chairaudio/ILSE/README.md

# ILSE. An Analog Monophonic Synthesizer Module

Schematic

Ilse is designed as a low cost, easy to build, but still flexible and feature rich synthesizer. 
It is based on Syntherjacks single-chip synthesizer [Totoro](https://syntherjack.net/totoro-1-ic-simple-synth/) and extends the design for voltage control on filter, oscillators and LFO.

## History
If you want to see the revision 1 of ILSE (as a reference if you have a REV 1 layout) make sure to check out the rev1 tag with `git checkout tags/rev1`

If you want to see the revision 2 of ILSE (as a reference if you have a REV 2 layout) make sure to check out the rev2 tag with `git checkout tags/rev2`

## Features
10 HP Eurorack module

Components: 

- two saw tooth oscillators
- brigded-T low pass filter with resonance switch 
- triangle LFO with speed control, and routing to filter or oscillators
- simple mixer and detune for oscillators
- level control
- external filter input

Modulation Inputs: 

- 1V/Oct input for oscillators
- Gate
- Filter Cutoff (exponential)
- LFO Speed (linear, via pin header)
- Oscillator 2 detune (linear, via pin header)

You might as well just examine the schematics in the simulator and  build your own synthesizer from it. It uses a neat trick to build the  exponential converters directly into the saw tooth oscillators as you  can see from the simulation below. Note that the tuning of the  oscillators is not temperature compensated and will thus change with  room temperature. We would not recommend using Ilse in a stage situation where reliable and exact pitches are important.

[Saw Tooth Oscillators](http://www.falstad.com/circuit/circuitjs.html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)

It features a simple voltage controllable low pass filter that you can modulate with the inbuilt LFO or an external source.

[Voltage Controlled Filter](http://www.falstad.com/circuit/circuitjs.html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)

Ilse was designed for educational use and was used in an introduction to electronics course. For more details on the schematics see the [course material](https://www.uni-weimar.de/kunst-und-gestaltung/wiki/IFD:Analog_Circuits_and_Interfaces_WS20_21/introduction_to_electronics).

## Kit building

Here you can find the [schematic](ilse.pdf) and [build instructions](https://discourse.chair.audio/t/ilse-build-instructions-for-revision-4/151/3). The [iBOM](https://chairaudio.github.io/ILSE/REV4.html) will help you assemble the kit.

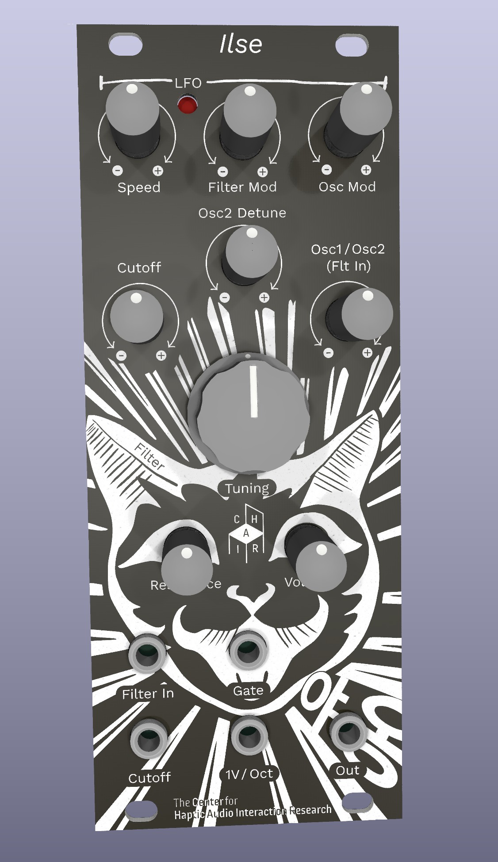
[picture p1: 3d_viewer.jpg]
KiCad 3d view


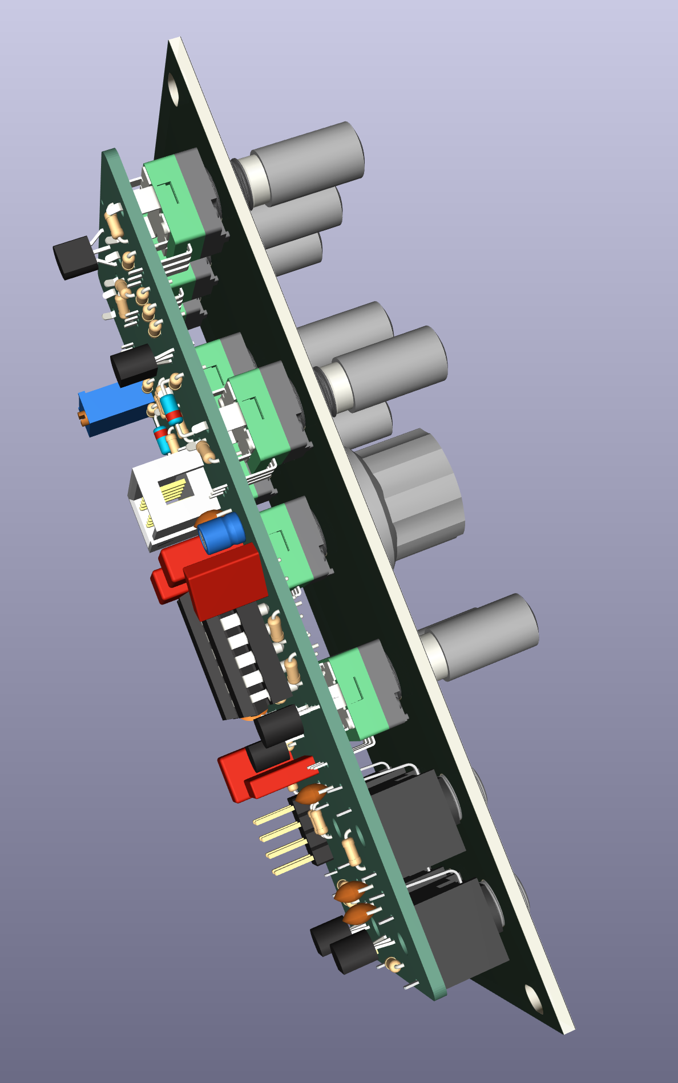
[picture p2: ilse2.png]


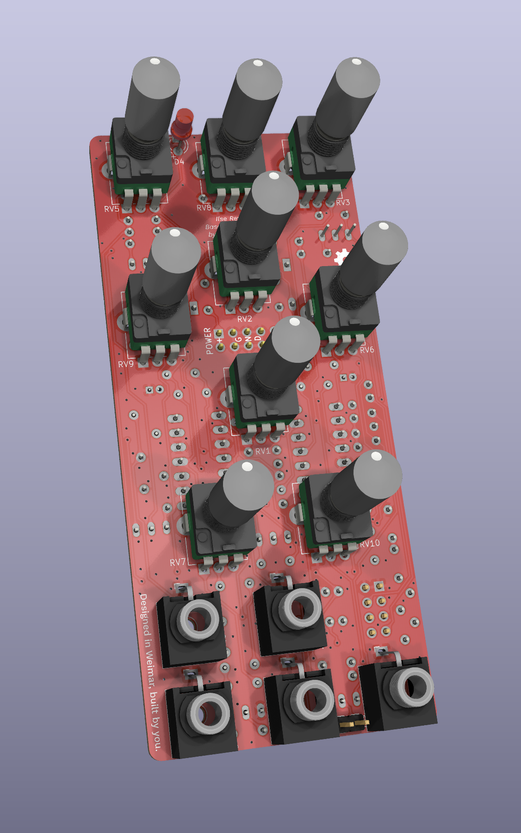
[picture p3: ilse3.png]


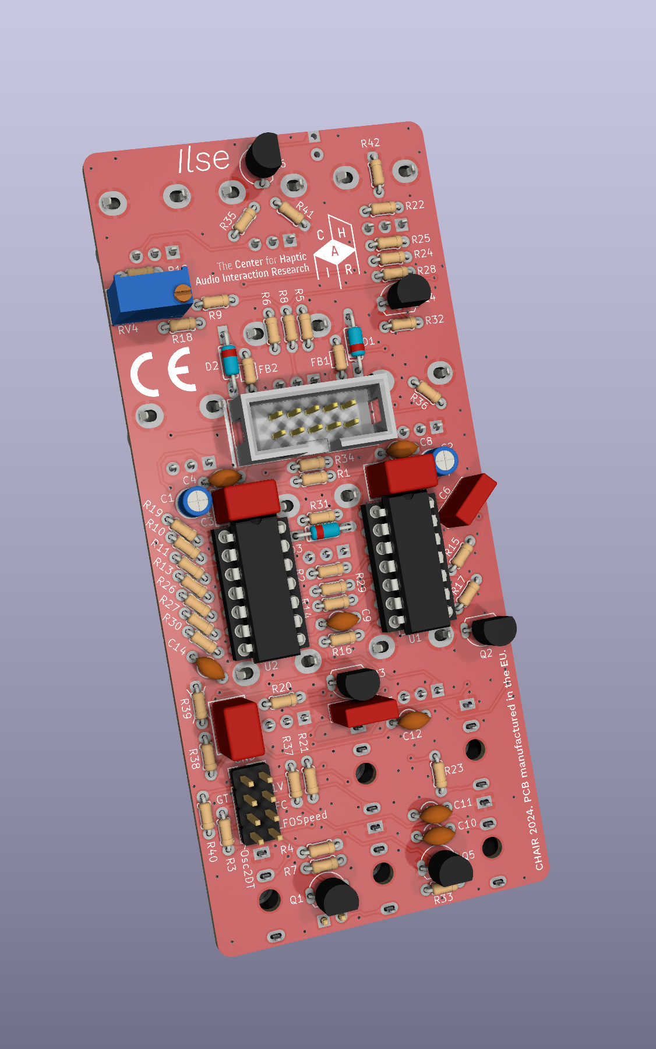
[picture p4: ilse4.png]
