chairaudio/ILSE/ilse_with_type.ods

ILSE Analog Synthesizer Module Parts List
Item No. | Type | Qty | Value
1 | Ceramic or Electrolytic Capacitor | 3 | 1u
2 | Ceramic Capacitor | 2 | 0.1u
3 | Ceramic Capacitor | 2 | 10n
4 | Ceramic Capacitor | 1 | 47n
5 | Ceramic Capacitor | 2 | 22n
6 | Ceramic Capacitor | 1 | 1n
7 | Electrolytic Capacitor | 2 | 10u
8 | Quad Operational Amplifier Chip | 2 | TL074 (evtl. Replace?)
9 | Leds | 2
10 | Mono Audio Connector Jack 3.5mm | 1
11 | Pin Header 2x5, 2.54mm Pin Distance | 1
12 | Pin Header 2x3, 2.54mm Pin Distance | 1
13 | Mono Audio Connector Jack 3.5mm | 1
14 | Mono Audio Connector Jack 3.5mm | 1
15 | Mono Audio Connector Jack 3.5mm | 1
16 | Mono Audio Connector Jack 3.5mm | 1
17 | Pin Header 2x1, 2.54mm Pin Distance | 1
18 | PNP Transistor | 3 | BC560 / BC558
19 | NPN Transistor | 3 | BC550 / BC548
20 | Resistor through-hole | 3 | 4k7
21 | Resistor through-hole | 7 | 47k
22 | Resistor through-hole | 10 | 100k
23 | Resistor through-hole | 3 | 1k
24 | Resistor through-hole | 1 | 22k
25 | Resistor through-hole | 2 | 1k
26 | Resistor through-hole | 3 | 47k
27 | Resistor through-hole | 4 | 100k
28 | Resistor through-hole | 1 | 1.5k
29 | Resistor through-hole | 4 | 10k
30 | Resistor through-hole | 1 | 2k2
31 | Potentiometer linear | 1 | 5kB
32 | Potentiometer linear | 5 | 100kB
33 | Trimmer, Trim-potentiometer | 1 | 500
34 | Potentiometer linear | 1 | 100kA
35 | Switch, DTDP | 1 | Power Switch
36 | Switch, DTDP | 1 | LFO Switch
37 | Switch, DTDP | 1 | Resonance Switch
