chairaudio/ILSE/ilse.pdf

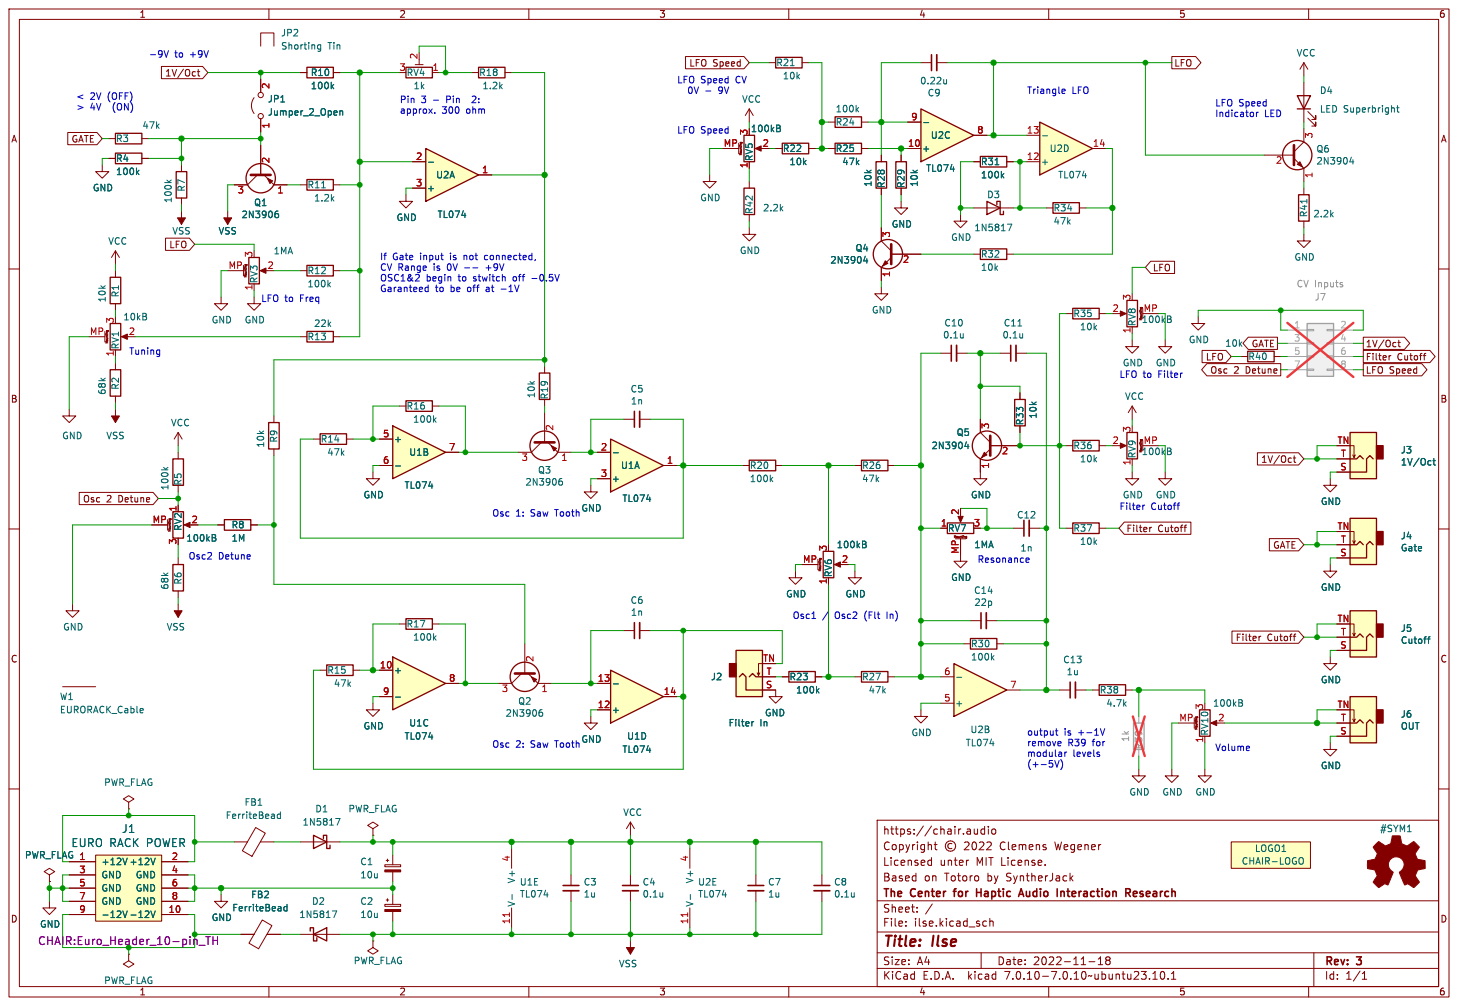
[picture p5: page 1]

LFO Speed
LFO to Filter LFO Speed CV

LFO to Freq < 2V (OFF) > 4V (ON)
