chairaudio/ILSE/(threads)

Thread 11 (2022-12-09):

pots: OSC2 opposite direction

mxa, 2022-12-09:

mxa, 2022-12-11:
So just flip pins 1 and 3 of OSC2 detune?

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

clwe, 2022-12-11:
Yes, a more negative voltage on the transistor increases the conductance and thus will tune the oscillator higher. I didn't think about this in the previous revisions.

Closed 2022-12-11.

Thread 13 (2022-12-09):

check filter input impedance

clwe, 2022-12-09:
Maybe input impedance for the filter could be improved by choosing R33 & R30 to be 100k instead of 10k.
Needs testing because filter linearising resistor may be impacted.

clwe, 2023-05-27:
fixed in commit 68551501455ced69077ff11da6b6c52eb0b032d7
The issue may not have been input impedance but rather the mixing of CV in front of the filter transistor. The CV range should be improved now.

Closed 2023-05-27.

Thread 4 (2022-12-09):

Diodes missing on BOM

mxa, 2022-12-09:

Closed 2023-05-27.

Thread 19 (2023-10-05):

change diode types

mxa, 2023-10-05:

mxa, 2023-10-05:
fixed with 2be08bc7447451915e4d4985e003920598b6d914

Closed 2023-10-05.

Thread 21 (2024-01-05):

osc modulation audible when fully turned down

clwe, 2024-01-05:
osc modulation audible when fully turned down. probably an impedance issue

clwe, 2024-01-05:
maybe fixed by 6c2b35c70b13fd999f63e0441a15eb7f75b7e570  (using larger tuning resistors)

clwe, 2024-01-06:
tested, mainly fixed with https://github.com/chairaudio/ILSE/commit/6c2b35c70b13fd999f63e0441a15eb7f75b7e570.
It wasn't the osc modulation, but cross modulation of oscillators that caused oscillators to be unstable. Cross modulation is decreased with bigger resistors.

Closed 2024-01-06.

Thread 25 (2025-01-28):

silkscreen label flt in should align right on osc1/osc2 mix

clwe, 2025-01-28:
external filter in replaces osc2 when something is plugged in.
to hear only the filter input the mix knob should be fully turned right

mxa, 2025-01-28:
Is this an issue for the frontplate design or the PCB?

clwe, 2025-01-28:
frontplate. just the silkscreen should be differntly aligned to give an indication where to turn the knob for external filter input
