chairaudio/ILSE/(commit log)

2021-01-17 add schematic and 3D Viewer screenshot
2021-01-17 adds schematic as png file
2021-12-09 choose volume pot as linear type
    [ilse.kicad_sch, ilse_rev1.ods]
2021-12-09 update README.md: include links to build instructions, simulations and course material
2022-11-18 incorporates max's powersupply protection
    [ilse.kicad_pcb, ilse.kicad_sch]
2022-11-18 removes filter distortion, cutoff modulation range is 0V - +10V, instead of -10V - +10V
    [ilse.kicad_sch]
2022-11-20 added hybrid lib
    [ilse.kicad_pcb, ilse.kicad_sch]
2022-11-22 include manf# for rev2
    [ilse.kicad_sch]
2022-11-23 edits in schematic
    [ilse.kicad_pcb, ilse.kicad_sch]
2022-11-23 adds old rev1 pcb
    [ilse-rev1.kicad_pcb]
2022-11-24 layout remake in process
    [ilse-rev1.kicad_pcb, ilse-rev2.kicad_pcb, ilse.kicad_pcb, ilse.kicad_sch]
2022-11-26 finished routing and squashed DRC errors down to 0
    [ilse.kicad_pcb, ilse.kicad_sch]
2022-11-27 started frontpanel file
    [frontpanel.kicad_pcb, frontpanel.kicad_sch, ilse-rev2.kicad_pcb, ilse.kicad_pcb]
2022-11-28 holes completed on frontpanel
    [frontpanel.kicad_pcb, ilse.kicad_pcb]
2022-11-29 frontpanel functional, CV input GND added
    [frontpanel.kicad_pcb, frontpanel.kicad_sch, ilse.kicad_pcb, ilse.kicad_sch]
2022-11-30 ready for review
    [frontpanel.kicad_pcb, ilse.kicad_pcb]
2022-11-30 JLCJLCJLCJLC added to PCBs
    [frontpanel.kicad_pcb, ilse.kicad_pcb]
2022-11-30 added visual gimmmicks
    [frontpanel.kicad_pcb, ilse.kicad_pcb]
2022-11-30 replaces resonance switch with pot
    [ilse.kicad_sch]
2022-11-30 connected pin 3 of RV9
    [ilse.kicad_pcb, ilse.kicad_sch]
2022-11-30 added fabrication output
    [frontpanel.kicad_pcb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]
2022-12-09 turned R13 label upright, closes #5, make LED footprint polarizaton evident, closes #2
    [ilse.kicad_pcb, ilse.kicad_sch]
2022-12-09 swap Freq Cutoff labels on Frontpanel, closes #10
    [frontpanel.kicad_pcb]
2022-12-09 make EURORACK Power footprint more evident, closes #3
    [ilse.kicad_pcb]
2022-12-09 close unconnected pins: Diode-Reistor Ratsnest, closes #9
    [ilse.kicad_pcb]
2022-12-10 updated images and schematic pdf for readme, closes #6
2022-12-11 inverse rotation on RV2, fixes #11
    [ilse.kicad_pcb, ilse.kicad_sch]
2023-01-28 changed RV9 from 1MB to 1MA, fixes #14
    [ilse.kicad_sch]
2023-01-30 added EURORACK Ribbon cable to schematic, layout and BOM, must update CHAIR library. fixes #15
    [ilse.kicad_pcb, ilse.kicad_sch]
2023-05-27 remove switch, add knob: LFO to filter depth, bigger filter caps
    [ilse.kicad_sch]
2023-05-27 replaces LFO cap to match cap in filter
    [ilse.kicad_sch]
2023-05-27 changes diodes from 1N5819 to 1N5818 (smaller Vf), fixes #4
    [ilse.kicad_sch]
2023-10-03 placing done
    [ilse.kicad_pcb, ilse.kicad_sch, ilseREV2.kicad_pcb]
2023-10-03 routing done
    [ilse.kicad_pcb]
2023-10-04 labels positioned
    [ilse.kicad_pcb]
2023-10-05 minor optimizations
    [ilse.kicad_pcb, ilse.kicad_sch]
2023-10-05 chaged diodes and transistors to alternatives
    [ilse.kicad_pcb, ilse.kicad_sch]
2023-10-05 routing optimizations
    [ilse.kicad_pcb, ilse.kicad_sch]
2023-10-05 exchanged pot and trimmer values, fixes #18
    [ilse.kicad_pcb, ilse.kicad_sch]
2023-10-05 added teardrops
    [ilse.kicad_pcb]
2023-10-15 finished routing
    [frontpanel.kicad_pcb, ilse.kicad_sch]
2023-10-15 updated layout and schematic
    [ilse.kicad_sch]
2023-10-15 removed resistor for standalone mode
    [ilse.kicad_sch]
2023-10-15 updated frontpanel
    [frontpanel.kicad_pcb]
2023-10-24 new footprints
    [ilse.kicad_sch]
2023-12-22 Some fixes after evaluation of prototype
    [frontpanel.kicad_pcb, ilse.kicad_sch]
2023-12-26 better qingpu jack footprint
    [frontpanel.kicad_pcb, ilse.kicad_pcb, ilse.kicad_sch]
2024-01-05 turned transistors around
    [frontpanel.kicad_pcb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]
2024-01-05 added CE mark
    [ilse.kicad_pcb, ilse.kicad_sch]
2024-01-05 changes filter frontend, LFO range and tuning resistors, fixes #20, #22, #23
    [ilse.kicad_sch]
2024-01-05 added cap and turned one transistor around
    [ilse.kicad_pcb]
2024-01-06 production version
    [ilse.kicad_pcb]
2024-01-06 corrects tuning offset and osc2 detune range + offset
    [ilse.kicad_sch]
2024-01-06 fix to board
    [ilse.kicad_pcb]
2024-01-09 change filter CV (R37) to 10k
    [ilse.kicad_sch]
2024-01-20 removed jumper for gate
    [ilse.kicad_pcb, ilse.kicad_sch]
2024-01-23 changed R39 from 1k to 1.2k
    [ilse.kicad_pcb, ilse.kicad_sch]
2024-01-24 cap values updated
    [ilse.kicad_sch]
2024-01-24 brought jumper back :(
    [ilse.kicad_pcb, ilse.kicad_sch]
2024-01-26 REV4 documentation and iBOM added
    [ilse.kicad_pcb]
2024-01-27 REV4 documentation and iBOM fixed
    [ilse.kicad_pcb]
2025-02-20 changing 3d model path to kicad v8
    [ilse.kicad_pcb, ilse.kicad_sch]
2025-02-23 changing 3d model path to kicad v9
    [ilse.kicad_pcb, ilse.kicad_sch]
