chairaudio/ILSE/(notices)

Notices in the files:
mainboard/ilse.kicad_sch:
Licensed unter MIT License.
Copyright © 2022 Clemens Wegener
mainboard/ilse.kicad_pcb:
License: CC BY-NC-SA
